Agilack/cowprobe-rp/hardware/readme.md

cowprobe-rp : Hardware
======================

This folder contains the hardware parts of cowprobe-rp project. The PCB
form-factor is made to fit into Hammond 1551 enclosure.

CAD source
----------

This board has been designed using KiCad EDA (version 6). All sources files
(schematics, routing, ...) are available into the `prj-kicad` folder.

<table>
<tr>
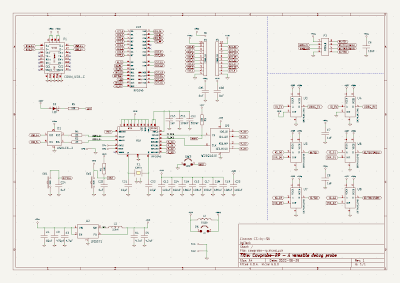
[picture p2: hardware/doc/kicad-sch-mini.png]
KiCad schematics
<td></td>
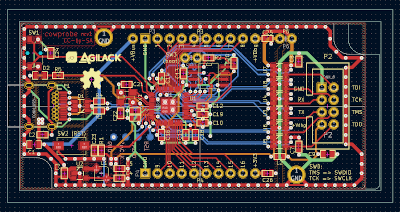
[picture p3: hardware/doc/kicad-routing-mini.png]
KiCad routing
<td></td>
</tr>
<tr>
<td>Fig1: Preview of the KiCad schematics</td>
<td>Fig2: Preview of the KiCad routing</td>
</tr>
</table>

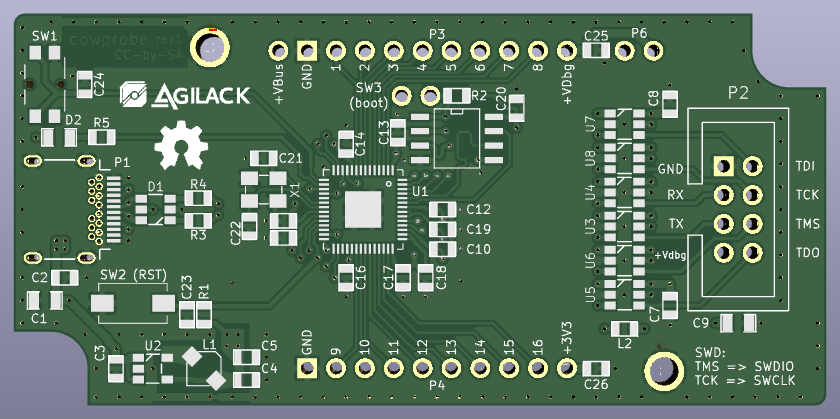
[picture p4: hardware/doc/kicad-3d.png]
PCB 3D preview


License
-------

This project is OpenHardware. You can use (and/or modify) this project under
terms of the Creative Commons ShareAlike license (CC-by-SA).
See [LICENSE.md](LICENSE.md).
