Agilack/cowprobe-rp/firmware/src/types.h

/**
 * @file  types.h
 * @brief Declaration for common types
 *
 * @author Saint-Genest Gwenael <gwen@cowlab.fr>
 * @copyright Cowlab (c) 2017
 *
 * @page License
 * CowStick-bootloader is free software: you can redistribute it and/or
 * modify it under the terms of the GNU Lesser General Public License
 * version 3 as published by the Free Software Foundation. You
 * should have received a copy of the GNU Lesser General Public
 * License along with this program, see LICENSE.md file for more details.
 * This program is distributed WITHOUT ANY WARRANTY see README file.
 */
#ifndef TYPES_H
#define TYPES_H

typedef unsigned int   uint;
typedef unsigned long  u32;
typedef unsigned short u16;
typedef unsigned char  u8;
typedef volatile unsigned long  vu32;
typedef volatile unsigned short vu16;
typedef volatile unsigned char  vu8;

#endif
