Agilack/cowprobe-rp/(commit log)

2022-08-29 --=={ Create Project }==--
    [cowprobe-rp.kicad_pcb, cowprobe-rp.kicad_sch]
2022-08-30 HW: Insert main connectors (USB and debug) and power supply
    [cowprobe-rp.kicad_pcb, cowprobe-rp.kicad_sch]
2022-09-01 HW: Insert processor (RP2040), clock and memery
    [cowprobe-rp.kicad_pcb, cowprobe-rp.kicad_sch]
2022-09-02 HW: Connect IOs to processor, add user button and status LED
    [cowprobe-rp.kicad_pcb, cowprobe-rp.kicad_sch]
2022-09-16 HW: Add extension port and fix zones
    [cowprobe-rp.kicad_pcb, cowprobe-rp.kicad_sch]
2022-09-17 = HW: Create production files for rev 1
    [cowprobe-rp-B_Cu.gbr, cowprobe-rp-B_Mask.gbr, cowprobe-rp-B_Paste.gbr, cowprobe-rp-B_Silkscreen.gbr, cowprobe-rp-Edge_Cuts.gbr, cowprobe-rp-F_Cu.gbr, cowprobe-rp-F_Mask.gbr, cowprobe-rp-F_Paste.gbr]
2022-09-27 = ADD: First pictures of PCB rev1
2022-10-05 Firmware: - Fix USB CMSIS driver (endpoints) - Implement first DAP commands (probe detected by OpenOCD)
    [cmsis.c, cmsis.h, main.c, usb.c, usb.h]
2022-10-20 Firmware: Improve CMSIS, move JTAG code to a new dedicated module test CMSIS/JTAG with an ESP32 target, sucessfully reads IDCODE but fails after (WiP)
    [cmsis.c, jtag.c, jtag.h, swd.c, swd.h]
